robin7331/pixel-pump-mainboard/readme.md

# Pixel Pump Mainboard Rev 8
`KiCad 6.0.11`

See iBOM [rendered as Page](https://htmlpreview.github.io/?https://github.com/robin7331/pixel-pump-mainboard/blob/main/bom/ibom.html) via GitHub Pages
