robin7331/pixel-pump-mainboard/dxf/DXF Import Offset Position.png

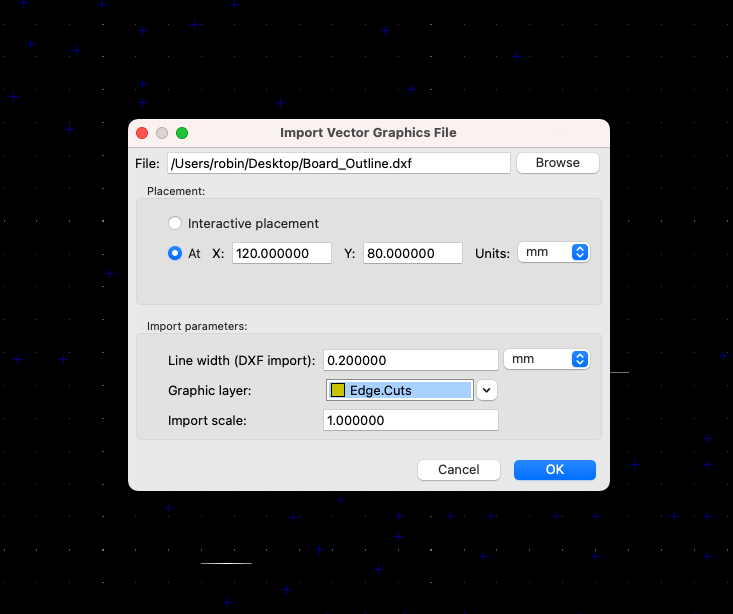
dxf/DXF Import Offset Position.png
