robin7331/pixel-pump-mainboard/components/RP2040/RP2040 v1.iges

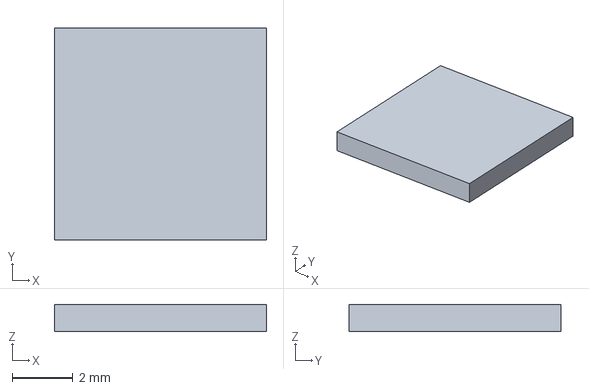
[picture p2: CAD file, 2021-06-08]
components/RP2040/RP2040 v1.iges
7.00 x 7.00 x 0.9 mm
