robin7331/pixel-pump-mainboard/dxf/fusion-360-edge-cuts.dxf

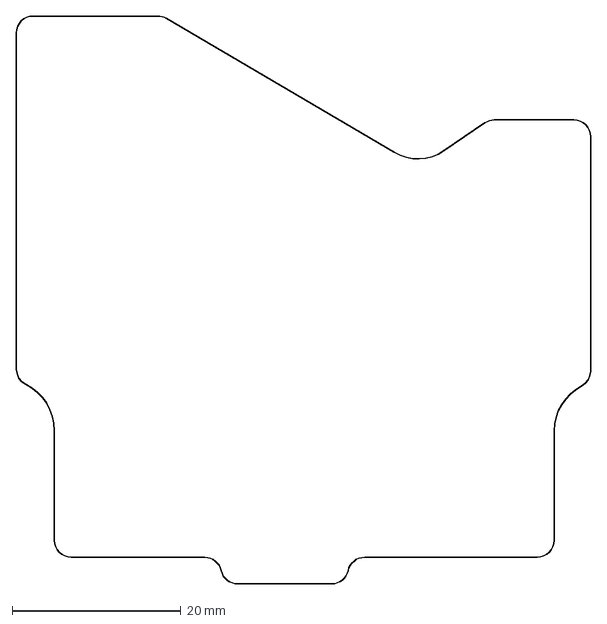
[picture p4: CAD file, 2021-06-08]
dxf/fusion-360-edge-cuts.dxf
68.0 x 67.3 mm
