robin7331/pixel-pump-mainboard/dxf/fusion-360-user-drawings.dxf

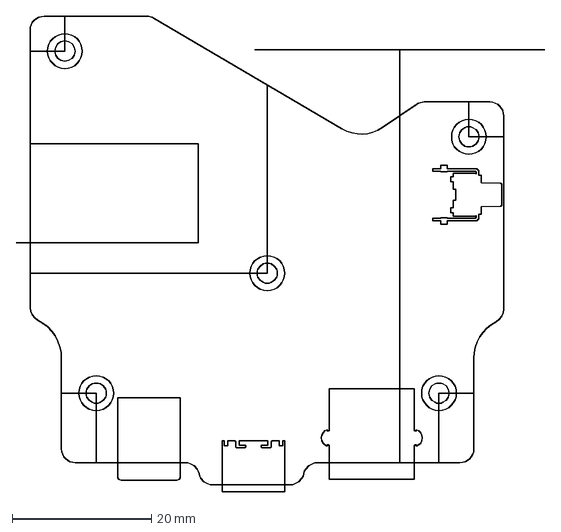
[picture p5: CAD file, 2021-06-08]
dxf/fusion-360-user-drawings.dxf
75.9 x 68.3 mm
