robin7331/pixel-pump-mainboard/pixel-pump-mainboard.kicad_pcb

## KiCad design pixel-pump-mainboard.kicad_pcb (2023-02-24)

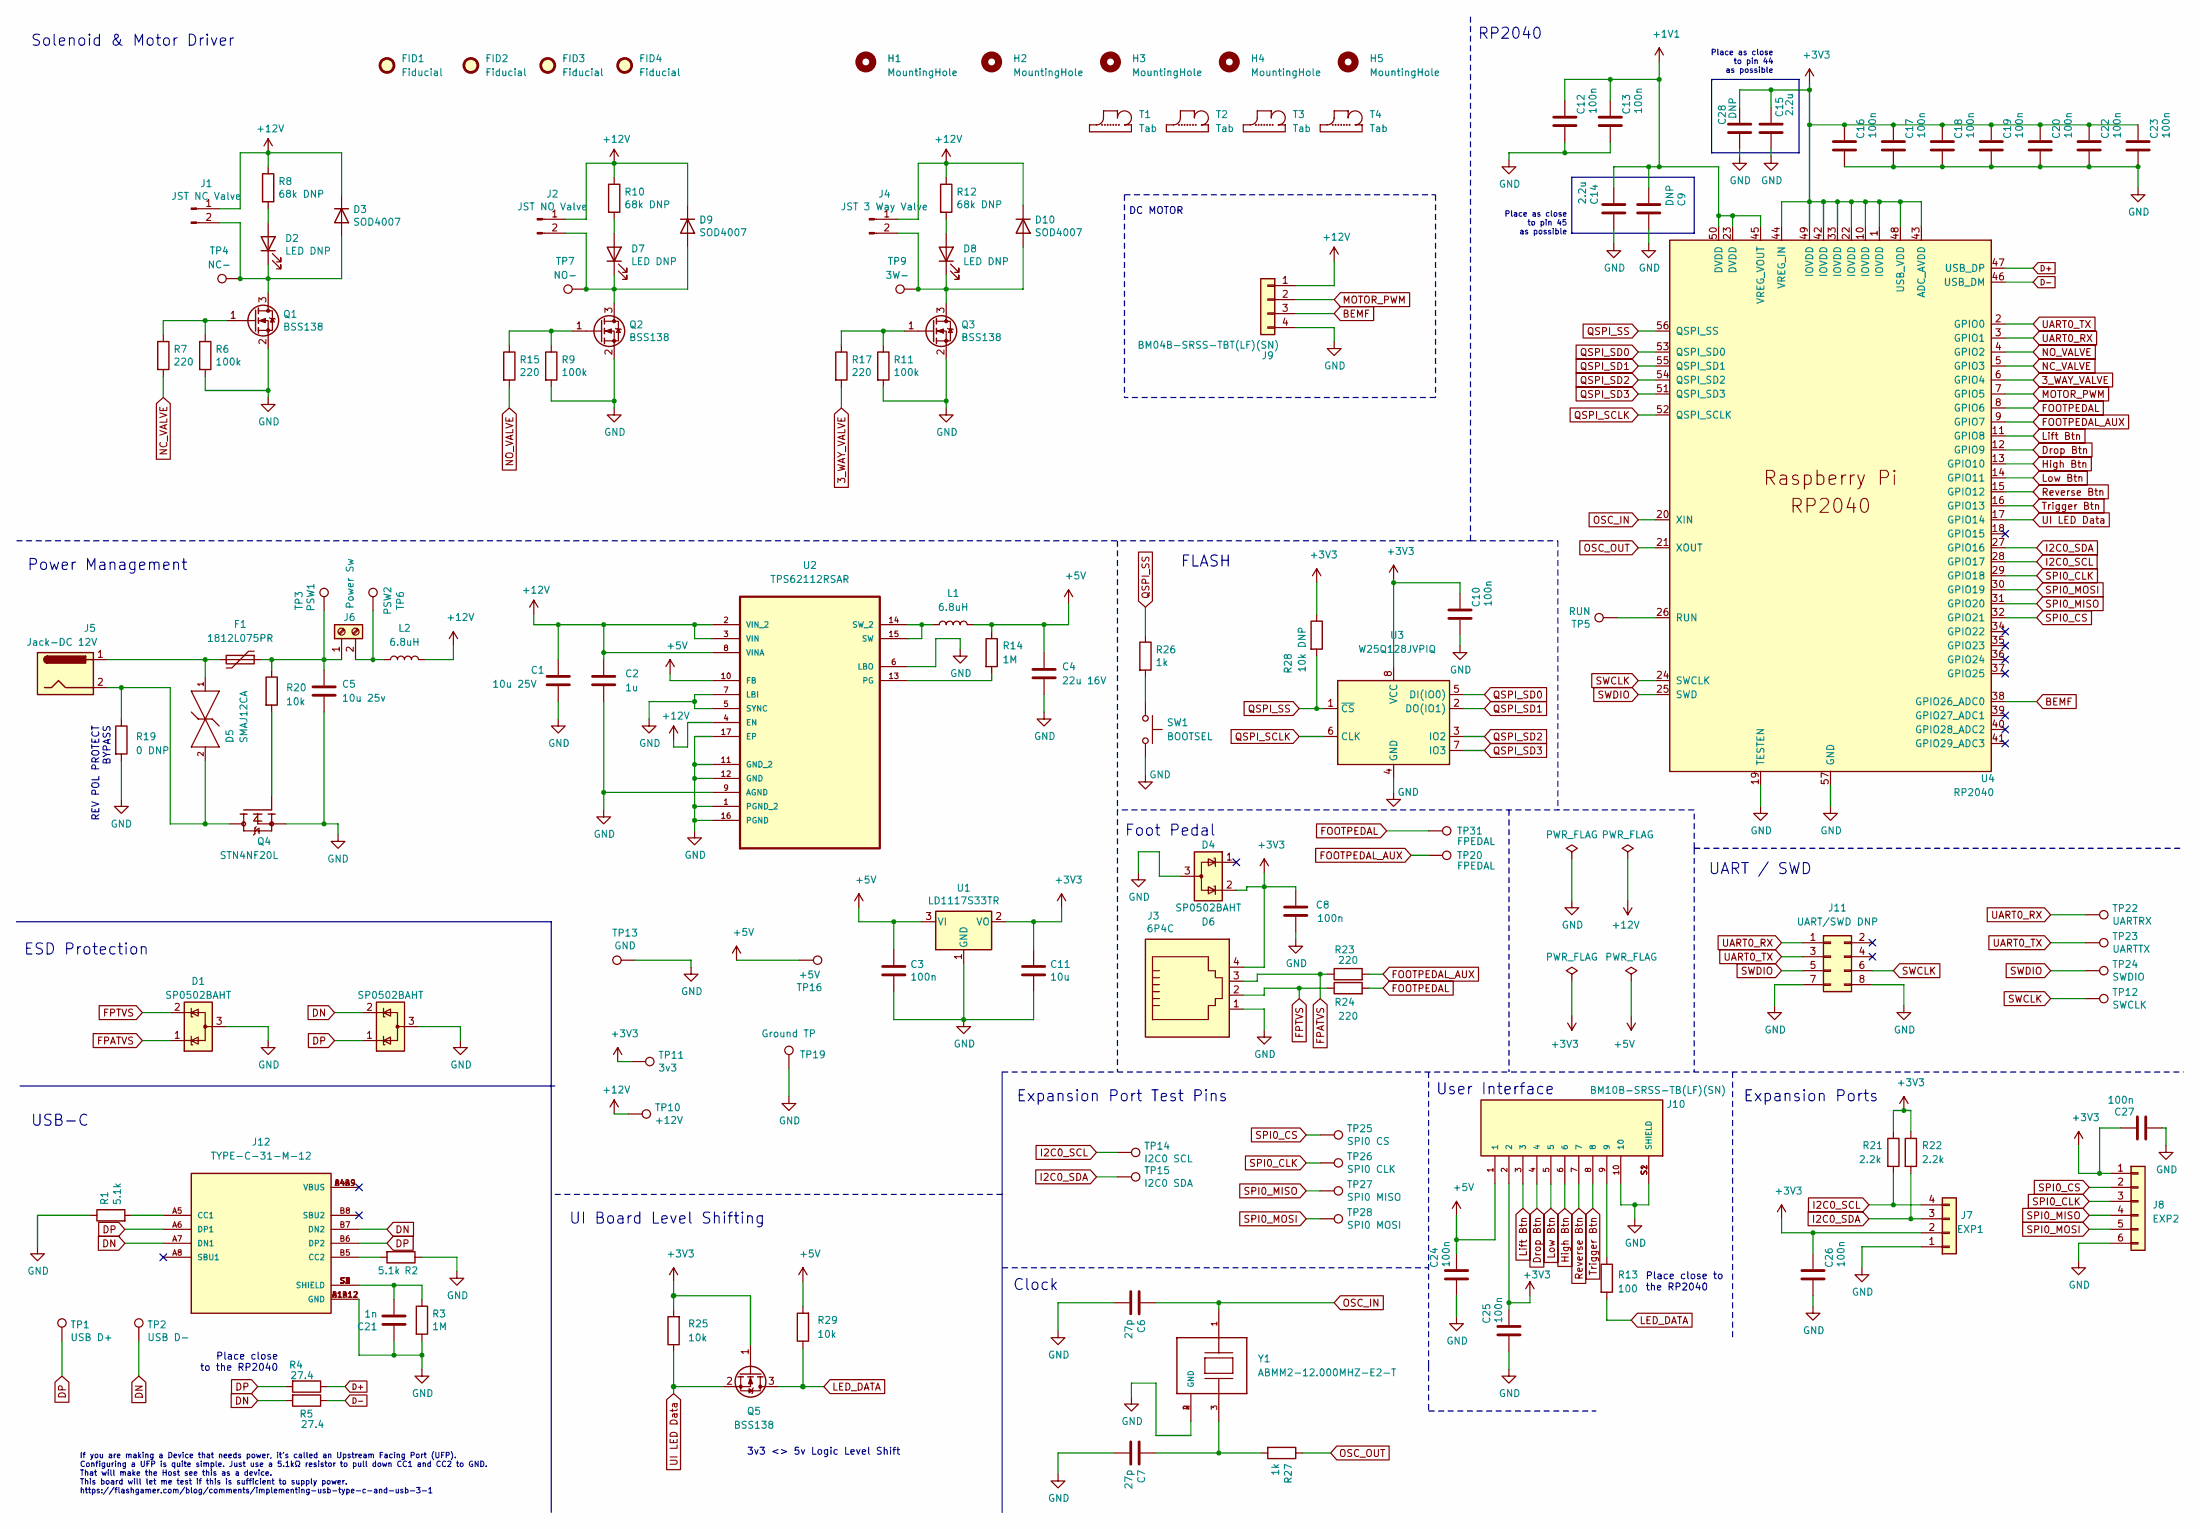
[picture p6: schematic pixel-pump-mainboard.kicad_sch, Pixel Pump Mainboard]

Parts:
C1: 10u 25V; C_1210_3225Metric; Part Number C3225X5R1E106K
C2: 1u; C_0805_2012Metric; MPN 1u 0805
C3, C8, C24, C25, C26, C27: 100n; C_0603_1608Metric; MPN 100n 0603
C4: 22u 16V; C_1210_3225Metric; MPN C3225X7R1C226M250AC
C5: 10u 25v; C_1210_3225Metric; Part C3225X5R1E106K
C6, C7: 27p; C_0603_1608Metric; MPN 27p 0603
C9, C28: DNP; C_0402_1005Metric; MPN DNP
C10, C12, C13, C16, C17, C18, C19, C20, C22, C23: 100n; C_0402_1005Metric; MPN 100n 0402
C11: 10u; C_0603_1608Metric; MPN 10u 0603
C14, C15: 2.2u; C_0402_1005Metric; MPN 2.2u 0402
C21: 1n; C_0603_1608Metric; MPN 1n 0603
D1, D4, D6: SP0502BAHT; SOT-23; MPN SP0502BAHT
D2, D7, D8: LED DNP; LED_0603_1608Metric; MPN ORH-G36G DNP
D3, D9, D10: SOD4007; D_SOD-123F; MPN SOD4007
D5: SMAJ12CA; D_SMA; breakdown voltage 13.3V; clamping voltage 19.9V; mouser part number 576-SMAJ12CA; digikey description TVS DIODE 12V 19.9V DO214AC
F1: 1812L075PR; Fuse_1812_4532Metric; MPN 1812L075PR
FID1, FID2, FID3, FID4: Fiducial; Fiducial_0.75mm_Mask1.5mm
H1, H2, H3, H4, H5: MountingHole; MountingHole_3.2mm_M3_Pad_Via
J1: JST NC Valve; JST_XH_B2B-XH-A_1x02_P2.50mm_Vertical; MPN B2B-XH-A-GU
J2: JST NO Valve; JST_XH_B2B-XH-A_1x02_P2.50mm_Vertical; MPN B2B-XH-A-GU
J3: 6P4C; RJ14_Connfly_DS1133-S4_Horizontal; MPN DS1133-S40BPX
J4: JST 3 Way Valve; JST_XH_B2B-XH-A_1x02_P2.50mm_Vertical; MPN B2B-XH-A-GU
J5: Jack-DC 12V; BarrelJack_Wuerth_6941xx301002; MPN 694106301002
J6: Power Sw; TerminalBlock_Phoenix_MKDS-1,5-2-5.08_1x02_P5.08mm_Horizont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; MPN WJ500V-5.08-2P
J7: EXP1; BM04B-SRSS-TBT; MPN BM04B-SRSS-TB(LF)(SN)
J8: EXP2; BM06B-SRSS-TBT; MPN BM06B-SRSS-TB(LF)(SN)
J9: BM04B-SRSS-TBT(LF)(SN); BM04B-SRSS-TBT; MPN BM04B-SRSS-TBT(LF)(SN)
J10: BM10B-SRSS-TB(LF)(SN); PARTREV N/A
J11: UART/SWD DNP; PinHeader_2x04_P2.00mm_Vertical; MPN DNP
J12: TYPE-C-31-M-12; HRO_TYPE-C-31-M-12; PARTREV A
L1, L2: 6.8uH; L_TDK_SLF7032; MPN SLF7032T-6R8M1R6-2-PF
Q1, Q2, Q3: BSS138; SOT-23; MPN BSS138P
Q4: STN4NF20L; SOT223; PARTNO 497-10779-1-ND
Q5: BSS138; SOT-23; MPN BSS138
R1: 5.1k; R_0603_1608Metric; MPN 5.1k 0402
R2: 5.1k; R_0603_1608Metric; MPN 5.1k 0603
R3, R14: 1M; R_0603_1608Metric; MPN 1M 0603
R4, R5: 27.4; R_0402_1005Metric; MPN 27.4 0402
R6, R9, R11: 100k; R_0603_1608Metric; MPN 100k 0603
R7, R15, R17, R23, R24: 220; R_0603_1608Metric; MPN 220 0603
R8, R10, R12: 68k DNP; R_0603_1608Metric; MPN 68k 0603 DNP
R13: 100; R_0603_1608Metric; MPN 100 0603
R19: 0 DNP; R_0805_2012Metric; MPN 0 0805 DNP
R20, R25, R29: 10k; R_0603_1608Metric; MPN 10k 0603
R21, R22: 2.2k; R_0603_1608Metric; MPN 2.2k 0603
R26, R27: 1k; R_0603_1608Metric; MPN 1k 0603
R28: 10k DNP; R_0603_1608Metric; MPN 10k 0603 DNP
SW1: BOOTSEL; SW_Tactile_SKHH_Angled; MPN 1825027-5
T1, T2, T3, T4: Tab
TP1: USB D+; TestPoint_Pad_D2.0mm
TP2: USB D-; TestPoint_Pad_D2.0mm
TP3: PSW1; TestPoint_Pad_D2.0mm
TP4: NC-; TestPoint_Pad_D2.0mm
TP5: RUN; TestPoint_Pad_D2.0mm
TP6: PSW2; TestPoint_Pad_D2.0mm
TP7: NO-; TestPoint_Pad_D2.0mm
TP9: 3W-; TestPoint_Pad_D2.0mm
TP10: +12V; TestPoint_Pad_D2.0mm
TP11: 3v3; TestPoint_Pad_D2.0mm
TP12: SWCLK; TestPoint_Pad_D2.0mm
TP13: GND; TestPoint_Pad_D2.0mm
TP14: I2C0 SCL; TestPoint_Pad_D2.0mm
TP15: I2C0 SDA; TestPoint_Pad_D2.0mm
TP16: +5V; TestPoint_Pad_D2.0mm
TP19: Ground TP; TestPoint_Keystone_5010-5014_Multipurpose
TP20, TP31: FPEDAL; TestPoint_Pad_D2.0mm
TP22: UARTRX; TestPoint_Pad_D2.0mm
TP23: UARTTX; TestPoint_Pad_D2.0mm
TP24: SWDIO; TestPoint_Pad_D2.0mm
TP25: SPI0 CS; TestPoint_Pad_D2.0mm
TP26: SPI0 CLK; TestPoint_Pad_D2.0mm
TP27: SPI0 MISO; TestPoint_Pad_D2.0mm
TP28: SPI0 MOSI; TestPoint_Pad_D2.0mm
U1: LD1117S33TR; SOT-223; MPN LD1117S33TR
U2: TPS62112RSAR; QFN65P400X400X100-17N; MPN TPS62112RSAR
U3: W25Q128JVPIQ; SON127P500X600X80-9N; MPN W25Q128JVPIQ
U4: RP2040; RP2040-QFN-56; MPN RP2040
Y1: ABMM2-12.000MHZ-E2-T; XTAL_ABMM2-12.000MHZ-E2-T; PARTREV 01.18.13

Connections:
3_WAY_VALVE: R17.2, U4.6 (GPIO4)
+1V1: C9.1, C12.2, C13.2, C14.1, U4.23 (DVDD), U4.45 (VREG_VOUT), U4.50 (DVDD)
+3V3: C8.2, C10.2, C11.1, C15.1, C16.2, C17.2, C18.2, C19.2, C20.2, C22.2, C23.2, C25.2, C26.2, C27.2, C28.1, D6.2 (K), J3.4, J7.2, J8.1, J10.2, Q5.1 (G), R21.1, R22.1, R25.2, R28.1, TP11.1, U1.2 (VO), U3.8 (VCC), U4.1 (IOVDD), U4.10 (IOVDD), U4.22 (IOVDD), U4.33 (IOVDD), U4.42 (IOVDD), U4.43 (ADC_AVDD), U4.44 (VREG_IN), U4.48 (USB_VDD), U4.49 (IOVDD)
+5V: C3.1, C4.1, C24.2, J10.1, L1.2, R14.1, R29.2, TP16.1, U1.3 (VI), U2.10 (FB)
+12V: C1.1, C2.1, D3.1 (K), D9.1 (K), D10.1 (K), J1.1, J2.1, J4.1, J9.1, L2.2, R8.1, R10.1, R12.1, TP10.1, U2.2 (VIN_2), U2.3 (VIN), U2.4 (EN), U2.8 (VINA)
BEMF: J9.3, U4.38 (GPIO26_ADC0)
D+: R4.1, U4.47 (USB_DP)
D-: R5.1, U4.46 (USB_DM)
DN: D4.2 (K), J12.A7 (DN1), J12.B7 (DN2), R5.2, TP2.1
DP: D4.1 (K), J12.A6 (DP1), J12.B6 (DP2), R4.2, TP1.1
Drop Btn: J10.4, U4.12 (GPIO9)
FOOTPEDAL: R24.2, TP31.1, U4.8 (GPIO6)
FOOTPEDAL_AUX: R23.2, TP20.1, U4.9 (GPIO7)
FPATVS: D1.1 (K), J3.3, R23.1
FPTVS: D1.2 (K), J3.2, R24.1
GND: C1.2, C2.2, C3.2, C4.2, C5.2, C6.2, C7.2, C8.1, C9.2, C10.1, C11.2, C12.1, C13.1, C14.2, C15.2, C16.1, C17.1, C18.1, C19.1, C20.1, C21.1, C22.1, C23.1, C24.1, C25.1, C26.1, C27.1, C28.2, D1.3 (A), D4.3 (A), D6.3 (A), J3.1, J7.1, J8.6, J9.4, J10.10, J10.S1 (SHIELD), J10.S2 (SHIELD), J11.7, J11.8, J12.A1B12 (GND), J12.B1A12 (GND), Q1.2 (S), Q2.2 (S), Q3.2 (S), Q4.3, R1.1, R2.1, R3.2, R6.2, R9.2, R11.2, R19.2, SW1.2, TP13.1, TP19.1, U1.1 (GND), U2.1 (PGND_2), U2.5 (SYNC), U2.6 (LBO), U2.7 (LBI), U2.9 (AGND), U2.11 (GND_2), U2.12 (GND), U2.16 (PGND), U2.17 (EP), U3.4 (GND), U4.19 (TESTEN), U4.57 (GND), Y1.2 (GND), Y1.4 (GND)
High Btn: J10.6, U4.13 (GPIO10)
I2C0_SCL: J7.4, R21.2, TP14.1, U4.28 (GPIO17)
I2C0_SDA: J7.3, R22.2, TP15.1, U4.27 (GPIO16)
LED_DATA: Q5.3 (D), R13.2, R29.1
Lift Btn: J10.3, U4.11 (GPIO8)
Low Btn: J10.5, U4.14 (GPIO11)
MOTOR_PWM: J9.2, U4.7 (GPIO5)
NC_VALVE: R7.2, U4.5 (GPIO3)
NO_VALVE: R15.2, U4.4 (GPIO2)
unnamed: C5.1, F1.1, J6.1, R20.1, TP3.1
unnamed: C7.1, R27.2, Y1.3
unnamed: C21.2, J12.S1 (SHIELD), J12.S2 (SHIELD), J12.S3 (SHIELD), J12.S4 (SHIELD), R3.1
unnamed: D2.1 (K), D3.2 (A), J1.2, Q1.3 (D), TP4.1
unnamed: D2.2 (A), R8.2
unnamed: D5.1, F1.2, J5.1
unnamed: D5.2, J5.2, Q4.2, Q4.T, R19.1
unnamed: D7.1 (K), D9.2 (A), J2.2, Q2.3 (D), TP7.1
unnamed: D7.2 (A), R10.2
unnamed: D8.2 (A), R12.2
unnamed: D8.1 (K), D10.2 (A), J4.2, Q3.3 (D), TP9.1
unnamed: J6.2, L2.1, TP6.1
unnamed: J10.9, R13.1
unnamed: J12.A5 (CC1), R1.2
unnamed: J12.B5 (CC2), R2.2
unnamed: L1.1, U2.14 (SW_2), U2.15 (SW)
unnamed: Q1.1 (G), R6.1, R7.1
unnamed: Q2.1 (G), R9.1, R15.1
unnamed: Q3.1 (G), R11.1, R17.1
unnamed: Q4.1, R20.2
unnamed: R14.2, U2.13 (PG)
unnamed: R26.2, SW1.1
unnamed: TP5.1, U4.26 (RUN)
OSC_IN: C6.1, U4.20 (XIN), Y1.1
OSC_OUT: R27.1, U4.21 (XOUT)
QSPI_SCLK: U3.6 (CLK), U4.52 (QSPI_SCLK)
QSPI_SD0: U3.5 (DI(IO0)), U4.53 (QSPI_SD0)
QSPI_SD1: U3.2 (DO(IO1)), U4.55 (QSPI_SD1)
QSPI_SD2: U3.3 (IO2), U4.54 (QSPI_SD2)
QSPI_SD3: U3.7 (IO3), U4.51 (QSPI_SD3)
QSPI_SS: R26.1, R28.2, U3.1 (~CS), U4.56 (QSPI_SS)
Reverse Btn: J10.7, U4.15 (GPIO12)
SPI0_CLK: J8.3, TP26.1, U4.29 (GPIO18)
SPI0_CS: J8.2, TP25.1, U4.32 (GPIO21)
SPI0_MISO: J8.4, TP27.1, U4.31 (GPIO20)
SPI0_MOSI: J8.5, TP28.1, U4.30 (GPIO19)
SWCLK: J11.6, TP12.1, U4.24 (SWCLK)
SWDIO: J11.5, TP24.1, U4.25 (SWD)
Trigger Btn: J10.8, U4.16 (GPIO13)
UART0_RX: J11.1, TP22.1, U4.3 (GPIO1)
UART0_TX: J11.3, TP23.1, U4.2 (GPIO0)
UI LED Data: Q5.2 (S), R25.1, U4.17 (GPIO14)

Notes on the sheet:
ESD Protection
FLASH
Clock
REV POL PROTECT BYPASS
DC MOTOR
Place close to the RP2040
UART / SWD
Expansion Port Test Pins
Place as close to pin 45 as possible
Power Management
Solenoid & Motor Driver
RP2040
User Interface
Place close to the RP2040
If you are making a Device that needs power, it’s called an Upstream Facing Port (UFP). Configuring a UFP is quite simple. Just use a 5.1kΩ resistor to pull down CC1 and CC2 to GND. That will make the Host see this as a device. This board will let me test if this is sufficient to supply power. http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
UI Board Level Shifting
3v3 <> 5v Logic Level Shift
Foot Pedal
USB-C
Place as close to pin 44 as possible
Expansion Ports

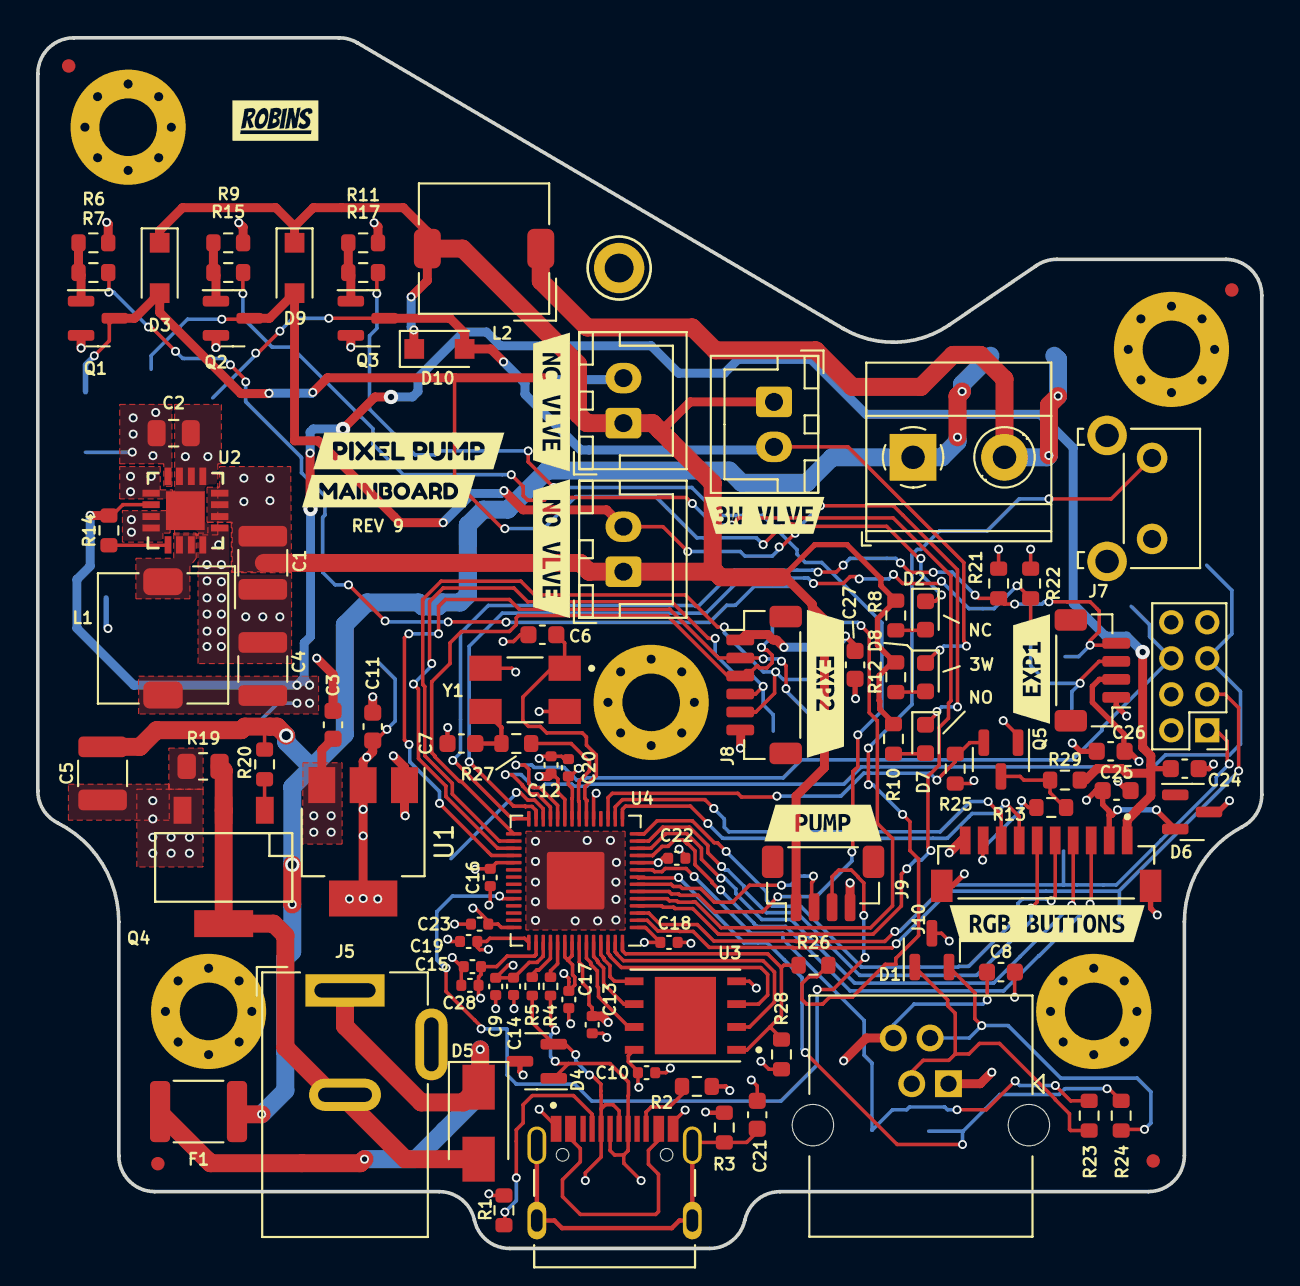
[picture p7: board pixel-pump-mainboard.kicad_pcb from above]

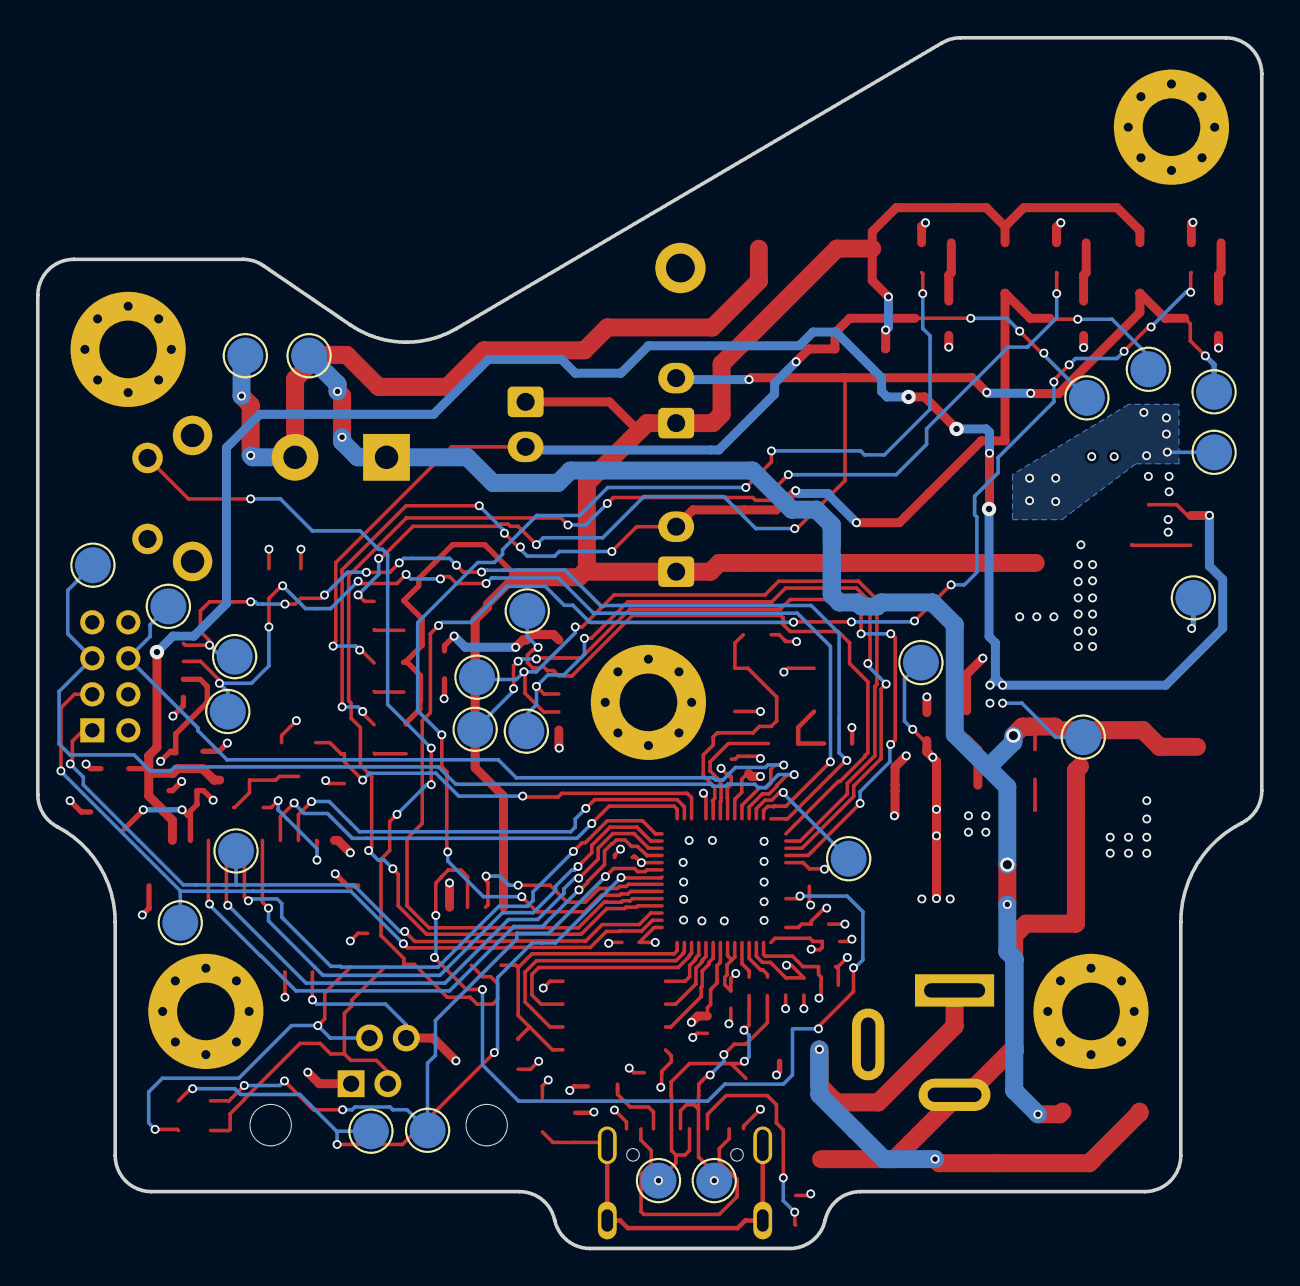
[picture p8: board pixel-pump-mainboard.kicad_pcb from below]

Board: 4 copper layers, 68.0 x 67.3 mm, 138 parts (24 on the bottom side), 67 nets.

Other parts of the board:
kibuzzard-62EBC211: G***; kibuzzard-62EBC211
kibuzzard-62EBC230: G***; kibuzzard-62EBC230
kibuzzard-626BB8E0: G***; kibuzzard-626BB8E0
kibuzzard-626BB906: G***; kibuzzard-626BB906
kibuzzard-6107E0E1: G***; kibuzzard-6107E0E1
kibuzzard-6107E4A2: G***; kibuzzard-6107E4A2
kibuzzard-6107E44E: G***; kibuzzard-6107E44E
kibuzzard-6107E45C: G***; kibuzzard-6107E45C
kibuzzard-6107E302: G***; kibuzzard-6107E302
