robin7331/pixel-pump-mainboard/(threads)

Thread 1 (2021-11-21):

Kicad version and pdf file of sch.

931436690, 2021-11-21:
Hi,
  What version of kicad do you use? Can you share the download link of the EDA software?The schematic diagram of the pdf file is easier to view. The files cannot be opened with the 5.1.12 version of kicad.
Thank you very much!

robin7331, 2021-11-21:
You have to have KiCad nightly in order to open the project.
The min version is ´KiCad Nightly 6.0.0-rc1-46-g1d2fd6d271` as seen in the [readme.md](https://raw.githubusercontent.com/robin7331/pixel-pump-mainboard/main/readme.md)

You can download KiCad nightly here by choosing your OS: https://kicad-downloads.s3.cern.ch/index.html?prefix=

Good point with the schematics as PDF. Will add it!

Closed 2021-11-21.

Thread 2 (2023-02-01):

PCB idea

oscarpeters, 2023-02-01:
Hi, I have looked at the design and found some improvements if I may :)

Does your manufacturer introduce extra costs for your Via construction? because the `annular ring` of some of your via's are less than `0.25mm` from the hole size.
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

other improvements:
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

Could make this a 3v3 plane:
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

lastly when making large quentities of these boards and maximum throughput from the pcb fab, I should no go further than 90 degress with copper traces, in these corners ething fluid can ingress and over time ruin the track.
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

C44Supra, 2023-02-08:
JLC used to have a minimum annular ring of 0.3mm on the small run proto orders but has moved down to .13mm for 1oz and .2mm for 2oz copper. Those numbers vary however from manufacturer to manufacturer, and larger batch runs typically grant you as the designer some extra freedom.

As for the acid trap thing, that hasn't been an issue for a few decades anymore, especially in professionally manufactured PCBs. If you're diying with etchant, try adding a bubbler and possibly rotating the pcbs during etching.

oscarpeters, 2023-02-09:
Most other manufactures add extra costs of having an annular ring smaller than 0,25. The yield will be less the smaller the annular ring will be.

C44Supra, 2023-02-09:
Not really. It's just a more involved process on 4 (or more) layer boards and little by little those processes are made available to lower count production runs too. Heck, can even get 4 layer boards at JLC for the price of a cheeseburger these days.

oscarpeters, 2023-02-09:
Have you used other manufactures then jlc?

robin7331, 2023-02-13:
Hey @oscarpeters and  @C44Supra,

So far I had no problems (or a higher fee) due to anything related to the PCB design.
Also the development of this very first release is done. Meaning I am not planning on doing any additional EMI testing for this revision. That means I'll not change anything on the design if not super cricital.

I highly appreciate your input and I'll leave this issue open until I am working on a new revision of this board.

Thread 3 (2024-05-08):

Possibility to use 2 solenoids

alextrical, 2024-05-08:
After looking over the design, I was slightly confused by the pneumatic plumbing of the device, hopefully I could make a suggestion to simplify the setup of the air path.

You should be able to use a single [4V110-06](https://www.aliexpress.com/item/4001216228059.html) intended for a pneumatic pistons, but use it in reverse, though its rather large, and will consume 3-5W of power
Alternatively 2 exhausted/3-way solenoids to flip the air flow, similar to [these ](https://www.aliexpress.com/item/1005005497520090.html)

I can sketch up a pneumatic circuit if you would like, to clarify how I believe it should be possible to plumb to achieve a reversible air flow

robin7331, 2024-05-17:
Appreciate your input. There were more criterie involved into the selection of valves than just simplification. It hat to fit inside the Pixel Pump, be compatible with the 2mm/4mm silicone hoses that were used everywhere else, etc.

So the 4V110-06 type of valve assembly does not meet all those requirements.

> Alternatively 2 exhausted/3-way solenoids to flip the air flow, similar to [these](https://www.aliexpress.com/item/1005005497520090.html)

Could you do a simple hand drawing how you intend to connect those?

alextrical, 2024-05-20:
Agreed that the 4V110-06 is too big for a project like this, though it's more of an example of a device to look out for (if they exist on a smaller scale)

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

I know the icons aren't exactly correct for pneumatics, but hopefully it's understandable. I've used a switch icon in place of the vented valves.
I believe that connecting a valve on either side of the pump, and a tee joining both values should do the pneumatics.
When the pump is running. Energising either solenoid will apply either a vacuum or pressure.

Under normal conditions I would expect that when one solenoid is activated, the other one will not be.

robin7331, 2024-05-20:
> though it's more of an example of a device to look out for (if they exist on a smaller scale)

I spent quite some time on sourcing and finding the right components for the pneumatics. I haven't found a better solution for the Pixel Pump than what I currently have. I'm open for suggestions if you find any other solution thats better (e.g. cheaper while still being good quality, smaller, simpler, etc.) 😋

> I know the icons aren't exactly correct for pneumatics, but hopefully it's understandable. I've used a switch icon in place of the vented valves.

I do see problems. Assuming the third, unused port of the valves is shut tight (which it has to be according to your drawing or you'll lose air pressure on the handle if it vents out the other valve) then there is no way in implementing the "pressure relief" functionality which is very important IMHO. Not only for the vacuum side but also for the positive pressure side.

alextrical, 2024-05-20:
> I'm open for suggestions if you find any other solution thats better (e.g. cheaper while still being good quality, smaller, simpler, etc.) 😋

Hopefully I can find something that can help this awesome project

> I do see problems. Assuming the third, unused port of the valves is shut tight... then there is no way in implementing the "pressure relief" functionality

I have yet to build a Vacuum Pick Pen, so I'm currently working on the following assumptions:
On button hold, A sustained vacuum is needed to lift and hold a part
On release, a positive pressure is required to blow the part off the tip

Wouldn't the pressure relief be able to be achieved by running the valves in positive pressure configuration.

I suppose the question I should be asking is, what benefit does the "pressure relief" functionality add to the product?

Thread 4 (2024-05-20):

Possible features to look into

alextrical, 2024-05-20:
Ive been intrigued by this project for the last few months and been thinking about possible modifications to its build.
The following are possible quality of life improvements:
-Run the system at 5 Volts, allowing the device to be powered over USB, and make use of ubiquitous phone chargers
-Replace the buttons with a [LVGL display ](https://lvgl.io/demos), something like this [ESP32-S3 based display](https://www.aliexpress.com/item/1005006625303218.html)
-Add a grounding wire to the handle to make the device ESD safe, possibly an enamel coated wire (magnet wire) run through the inside of the tube up to the handle, and grounded back in the base station could work?

If the display is used:
-The foot pedal can be made wireless, using an ESP8266 and a LiPo battery. ESPNow should be a viable option to send the start/stop signal to the main unit, and still have a long battery life (even if using a coin cell)
-Add a [pressure sensor](https://www.aliexpress.com/item/1005003534270728.html), this would allow setting the pressure, rather than just the power to the pump, to be more standard across devices.
-Multiple profiles could be setup, or set per nozzle size
-Could connect to a PC over USB, WiFi or Bluetooth. USB can be used to emulate a keyboard (as per the current setup)  or wireless using Bluetooth

Closed 2025-03-21.

Thread 5 (2024-07-29):

Routing suggestions for USB

wszeto9, 2024-07-29:
You could swap DN and DP on D4. It makes routing the diff pair possible without vias. Not that important but thought I'd bring it up if you wanted to improve on it for the next revision.

Before:
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

After:
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

robin7331, 2024-07-29:
Hey! Swapping pins is not possible as it is a three pin package.
But maybe we can rotate the TVS diode 180° like so:

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

Anyways. Good input. Thanks! Will leave the issue open for the next revision.
