robin7331/pixel-pump-mainboard/(commit log)

2020-12-18 schematics finished
    [sucker-one-mainboard.sch]
2020-12-21 schematics done
    [sucker-one-mainboard.sch]
2020-12-22 another wip
    [sucker-one-mainboard.kicad_pcb, sucker-one-mainboard.sch]
2020-12-22 routing finished
    [sucker-one-mainboard.kicad_pcb]
2020-12-22 added molex
    [sucker-one-mainboard.kicad_pcb, sucker-one-mainboard.sch]
2020-12-22 last changes and gerber files generated
    [sucker-one-mainboard-B_Cu.gbr, sucker-one-mainboard-B_Mask.gbr, sucker-one-mainboard-B_Paste.gbr, sucker-one-mainboard-B_SilkS.gbr, sucker-one-mainboard-Edge_Cuts.gbr, sucker-one-mainboard-F_Cu.gbr, sucker-one-mainboard-F_Mask.gbr, sucker-one-mainboard-F_Paste.gbr]
2020-12-22 added ibom
    [sucker-one-mainboard.kicad_pcb]
2021-01-14 Cleanup values
    [sucker-one-mainboard.kicad_pcb, sucker-one-mainboard.sch]
2021-01-14 Fix wrong boost feedback voltage divider resistors
    [sucker-one-mainboard.sch]
2021-01-14 Dim LEDs by increasing their resistor values
    [sucker-one-mainboard.sch]
2021-01-14 Fix both fuse footprints (they were swapped)
    [sucker-one-mainboard.kicad_pcb, sucker-one-mainboard.sch]
2021-01-14 Update silkscreen labels
    [sucker-one-mainboard.kicad_pcb, sucker-one-mainboard.sch]
2021-03-03 Add DXF files from fusion
    [fusion-360-edge-cuts.dxf, fusion-360-user-drawings.dxf]
2021-03-08 remove old files
    [sucker-one-mainboard-B_Cu.gbr, sucker-one-mainboard-B_Mask.gbr, sucker-one-mainboard-B_Paste.gbr, sucker-one-mainboard-B_SilkS.gbr, sucker-one-mainboard-Edge_Cuts.gbr, sucker-one-mainboard-F_Cu.gbr, sucker-one-mainboard-F_Mask.gbr, sucker-one-mainboard-F_Paste.gbr]
2021-03-08 Finished schematics
    [sucker-one-mainboard.kicad_sch]
2021-03-09 finished schematics and assigned footprints
    [sucker-one-mainboard.kicad_sch]
2021-03-09 Remove old PCB
    [sucker-one-mainboard.kicad_pcb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]
2021-03-09 Initial PCB
    [sucker-one-mainboard.kicad_pcb]
2021-03-09 Update USB-C
    [sucker-one-mainboard.kicad_sch]
2021-03-09 Updated PCB
    [sucker-one-mainboard.kicad_pcb]
2021-03-09 Edge cuts update
    [fusion-360-edge-cuts.dxf, fusion-360-user-drawings.dxf, sucker-one-mainboard.kicad_pcb]
2021-03-09 Placed components
    [fusion-360-user-drawings.dxf, sucker-one-mainboard.kicad_pcb, sucker-one-mainboard.kicad_sch]
2021-03-09 pcb layout finished
    [sucker-one-mainboard.kicad_pcb, sucker-one-mainboard.kicad_sch]
2021-03-09 Adjusted board thickness to be 1.6mm
    [sucker-one-mainboard.kicad_pcb]
2021-03-10 Generate gerbers
    [sucker-one-mainboard-B_Cu.gbr, sucker-one-mainboard-B_Mask.gbr, sucker-one-mainboard-B_Paste.gbr, sucker-one-mainboard-B_Silkscreen.gbr, sucker-one-mainboard-Edge_Cuts.gbr, sucker-one-mainboard-F_Cu.gbr, sucker-one-mainboard-F_Mask.gbr, sucker-one-mainboard-F_Paste.gbr]
2021-03-11 Generated Gerbers
    [sucker-one-mainboard-B_Cu.gbr, sucker-one-mainboard-B_Mask.gbr, sucker-one-mainboard-B_Paste.gbr, sucker-one-mainboard-B_Silkscreen.gbr, sucker-one-mainboard-Edge_Cuts.gbr, sucker-one-mainboard-F_Cu.gbr, sucker-one-mainboard-F_Mask.gbr, sucker-one-mainboard-F_Paste.gbr]
2021-03-27 Create schematic PDF
    [sucker-one-mainboard.kicad_sch]
2021-05-17 STM32 version
    [sucker-one-mainboard.kicad_pcb, sucker-one-mainboard.kicad_sch]
2021-05-17 Change DC-DC 5V converter to TPS561201DDCR
    [sucker-one-mainboard.kicad_sch]
2021-05-17 Change from STM32 to RP2040
    [sucker-one-mainboard.kicad_sch]
2021-05-17 Assign or update remaining footprints
    [sucker-one-mainboard.kicad_sch]
2021-05-17 Update crystal and footprints of components
    [sucker-one-mainboard.kicad_pcb, sucker-one-mainboard.kicad_sch]
2021-05-19 RP2040 PCB routed
    [RP2040 v1.iges, fusion-360-edge-cuts.dxf, fusion-360-user-drawings.dxf, sucker-one-mainboard.kicad_pcb, sucker-one-mainboard.kicad_sch]
2021-05-19 Add fiducials
    [sucker-one-mainboard-B_Cu.gbr, sucker-one-mainboard-B_Mask.gbr, sucker-one-mainboard-B_Paste.gbr, sucker-one-mainboard-B_Silkscreen.gbr, sucker-one-mainboard-Edge_Cuts.gbr, sucker-one-mainboard-F_Cu.gbr, sucker-one-mainboard-F_Mask.gbr, sucker-one-mainboard-F_Paste.gbr]
2021-05-20 Updated min via drill and pad size
    [sucker-one-mainboard-B_Cu.gbr, sucker-one-mainboard-B_Mask.gbr, sucker-one-mainboard-B_Paste.gbr, sucker-one-mainboard-B_Silkscreen.gbr, sucker-one-mainboard-Edge_Cuts.gbr, sucker-one-mainboard-F_Cu.gbr, sucker-one-mainboard-F_Mask.gbr, sucker-one-mainboard-F_Paste.gbr]
2021-08-02 Change various things
    [sucker-one-mainboard.kicad_sch]
2021-08-02 Bump rev to 2
    [sucker-one-mainboard.kicad_sch]
2021-08-02 Assign footprints
    [sucker-one-mainboard.kicad_sch]
2021-08-02 WiP updating footprints
    [sucker-one-mainboard.kicad_pcb, sucker-one-mainboard.kicad_sch]
2021-08-02 Updated kicad nightly
    [sucker-one-mainboard.kicad_pcb, sucker-one-mainboard.kicad_sch]
2021-08-02 WiP Layout Ref 2
    [sucker-one-mainboard.kicad_pcb, sucker-one-mainboard.kicad_sch]
2021-08-02 Finished Ref 2 layout
    [sucker-one-mainboard.kicad_pcb]
2021-08-02 Update passives around RP2040
    [sucker-one-mainboard.kicad_pcb]
2021-08-02 Add UI board level shifting
    [sucker-one-mainboard.kicad_pcb, sucker-one-mainboard.kicad_sch]
2021-08-02 Updated pad below RP2040
    [sucker-one-mainboard.kicad_pcb, sucker-one-mainboard.kicad_sch]
2021-08-03 Changed Buck Converter
    [sucker-one-mainboard.kicad_pcb, sucker-one-mainboard.kicad_sch]
2021-08-03 Add missing components
    [würth 694106301002 (rev1).stp]
2021-08-03 Minor upgrades
    [sucker-one-mainboard.kicad_pcb, sucker-one-mainboard.kicad_sch]
2021-08-03 Remove old schematics
2021-08-03 Plot board
2021-08-03 Update footprints and generate new iBOM
    [sucker-one-mainboard.kicad_pcb, sucker-one-mainboard.kicad_sch]
2021-08-06 Generate iBOM
    [sucker-one-mainboard.kicad_pcb]
2021-08-06 Changed part no and regenerated iBOM
    [sucker-one-mainboard.kicad_sch]
2021-08-06 Generate rev 2 gerbers
    [sucker-one-mainboard-B_Cu.gbr, sucker-one-mainboard-B_Mask.gbr, sucker-one-mainboard-B_Paste.gbr, sucker-one-mainboard-B_Silkscreen.gbr, sucker-one-mainboard-Edge_Cuts.gbr, sucker-one-mainboard-F_Cu.gbr, sucker-one-mainboard-F_Mask.gbr, sucker-one-mainboard-F_Paste.gbr]
2021-11-19 Rename entire project to pixel pump
    [pixel-pump-mainboard-B_Cu.gbr, pixel-pump-mainboard-B_Mask.gbr, pixel-pump-mainboard-B_Paste.gbr, pixel-pump-mainboard-B_Silkscreen.gbr, pixel-pump-mainboard-Edge_Cuts.gbr, pixel-pump-mainboard-F_Cu.gbr, pixel-pump-mainboard-F_Mask.gbr, pixel-pump-mainboard-F_Paste.gbr]
2021-11-19 Clean footprint library
    [pixel-pump-mainboard.kicad_sch]
2021-11-19 Cleanup board libraries
2021-11-21 Add PDF/PNG schematic
2022-01-10 Upgrade to Kicad 6
    [pixel-pump-mainboard.kicad_sch]
2022-01-11 Updated schematic for EMI compliance
    [pixel-pump-mainboard.kicad_sch]
2022-01-11 Minor Rev 3 changes
    [pixel-pump-mainboard.kicad_sch]
2022-01-11 Minor things fixed
    [pixel-pump-mainboard.kicad_sch]
2022-01-12 ERC & Assigned footprints
    [pixel-pump-mainboard.kicad_sch]
2022-01-12 Updated layout for EMI specific changes
    [pixel-pump-mainboard.kicad_pcb, pixel-pump-mainboard.kicad_sch]
2022-01-14 Finish EMI changes
    [pixel-pump-mainboard.kicad_pcb, pixel-pump-mainboard.kicad_sch]
2022-01-14 Remove old gerbers
2022-01-14 Adjusted spacing between testpoints
    [pixel-pump-mainboard.kicad_pcb]
2022-01-15 Add automatic gerber creation to build scriot
2022-01-16 Cleanup dxf files
    [fusion-360-edge-cuts.dxf, fusion-360-user-drawings.dxf]
2022-04-29 Rename ports to EXP1 and EXP2 and reduce mousebite stiffness
    [pixel-pump-mainboard.kicad_pcb, pixel-pump-mainboard.kicad_sch]
2022-05-23 Switch to CTS 445C25D12M00000 12 MHz crystal
    [pixel-pump-mainboard.kicad_pcb, pixel-pump-mainboard.kicad_sch]
2022-07-25 Revert back to ABM12 footprint
    [pixel-pump-mainboard.kicad_pcb, pixel-pump-mainboard.kicad_sch]
2022-08-04 Assign all MPNs
    [pixel-pump-mainboard.kicad_pcb, pixel-pump-mainboard.kicad_sch]
2022-08-04 Add robins logo
    [pixel-pump-mainboard.kicad_pcb]
2022-08-04 Change appearance of labels
    [pixel-pump-mainboard.kicad_pcb]
2022-08-04 Change appearance of labels (again)
    [pixel-pump-mainboard.kicad_pcb]
2023-01-09 Add essemtec pnp csv file
    [pixel-pump-mainboard-pnp.csv]
2023-01-09 Fix USB position in pnp csv
    [pixel-pump-mainboard-pnp.csv]
2023-01-12 Correctly rotate LDO
    [pixel-pump-mainboard-pnp.csv]
2023-01-30 Add fiducials and fix THT parts to be SMD
    [pixel-pump-mainboard.kicad_pcb, pixel-pump-mainboard.kicad_sch]
2023-01-30 Bump rev to 8
    [pixel-pump-mainboard.kicad_pcb]
2023-01-31 Remove DNP parts from BOM, increase Fiducial to 0.75/1.5mm
    [pixel-pump-mainboard.kicad_pcb, pixel-pump-mainboard.kicad_sch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]
2023-01-31 Add Aisler Bridge marks
    [pixel-pump-mainboard.kicad_pcb]
2023-01-31 Update Aisler bridge locations
    [pixel-pump-mainboard.kicad_pcb]
2023-01-31 Update Aisler bridge lines
    [pixel-pump-mainboard.kicad_pcb]
2023-02-10 Remove Aisler Outline markers
    [pixel-pump-mainboard.kicad_pcb]
2023-02-11 Add KiKit annotations
    [pixel-pump-mainboard.kicad_pcb, pixel-pump-mainboard.kicad_sch]
2023-02-13 Remove gerbers from gitignore
2023-02-13 Rev 8 panel settings and export
    [pixel-pump-mainboard-panel-CmtUser.gbr, pixel-pump-mainboard-panel-CuBottom.gbl, pixel-pump-mainboard-panel-CuTop.gtl, pixel-pump-mainboard-panel-EdgeCuts.gm1, pixel-pump-mainboard-panel-MaskBottom.gbs, pixel-pump-mainboard-panel-MaskTop.gts, pixel-pump-mainboard-panel-PasteBottom.gbp, pixel-pump-mainboard-panel-PasteTop.gtp]
2023-02-24 Fixed issues and generated the final pos file
    [pixel-pump-mainboard.kicad_pcb, pixel-pump-mainboard.kicad_sch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]
2023-02-24 Rev 9
    [pixel-pump-mainboard.kicad_pcb]
2023-02-24 Panelize Rev 9
    [pixel-pump-mainboard-panel-CmtUser.gbr, pixel-pump-mainboard-panel-CuBottom.gbl, pixel-pump-mainboard-panel-CuTop.gtl, pixel-pump-mainboard-panel-EdgeCuts.gm1, pixel-pump-mainboard-panel-MaskBottom.gbs, pixel-pump-mainboard-panel-MaskTop.gts, pixel-pump-mainboard-panel-PasteBottom.gbp, pixel-pump-mainboard-panel-PasteTop.gtp]
2023-02-24 Fix fiducial positions
    [pixel-pump-mainboard.kicad_pcb]
2023-02-24 Change kikit mouebite width to 2mm
    [pixel-pump-mainboard.kicad_pcb]
2023-02-24 Panelized again :/
    [pixel-pump-mainboard-panel-CmtUser.gbr, pixel-pump-mainboard-panel-CuBottom.gbl, pixel-pump-mainboard-panel-CuTop.gtl, pixel-pump-mainboard-panel-EdgeCuts.gm1, pixel-pump-mainboard-panel-MaskBottom.gbs, pixel-pump-mainboard-panel-MaskTop.gts, pixel-pump-mainboard-panel-PasteBottom.gbp, pixel-pump-mainboard-panel-PasteTop.gtp]
